eSpark-Backup/eyadkishawi-interfaceboard/README.md

# eyadkishawi-InterfaceBoard

- Transfer schematic to Altium.
- Modify schematics, layout and BOM to make the following modifications:
  - Remove R12 and leave open
  - Modify C10 to connect from R13 to GND.



  - c.	Replace C32 with 10uF Tantalum capacitor rated at 35V, such as TCJB106M035R0200.



- Rename the project to 7000-0303_Rev13.
- Schematic and more details are in the docs folder.
