eSpark-Backup/eyadkishawi-interfaceboard/docs/Requirements/7000-0303_r12_c10_mod_032323.pdf

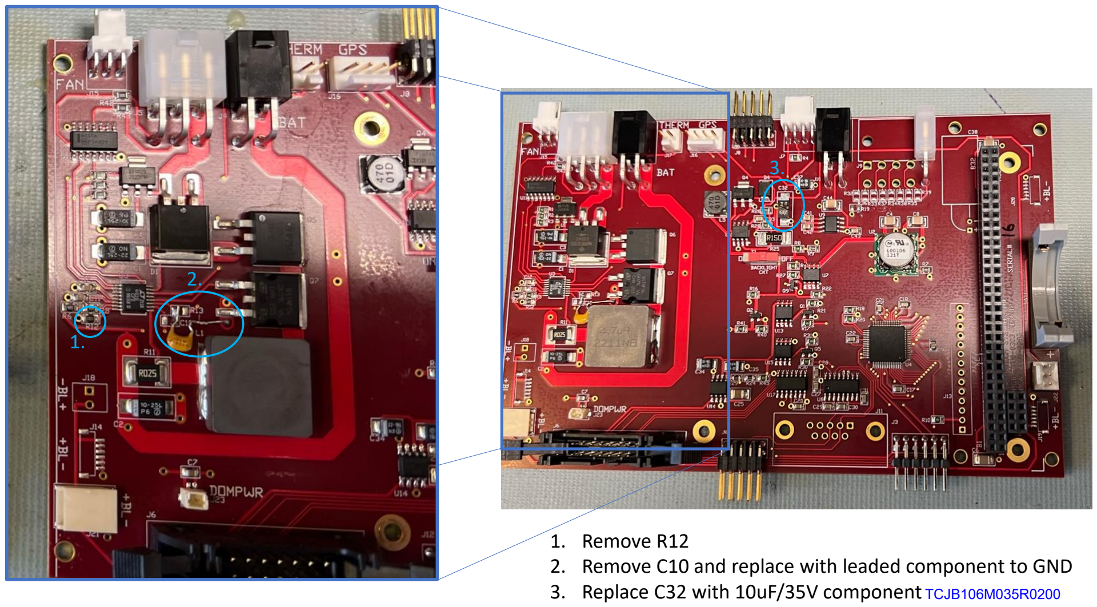
[picture p3: page 1]

1. Remove R12
2. Remove C10 and replace with leaded component to GND
3. Replace C32 with 10uF/35V component

1.

2.

3.

TCJB106M035R0200
