eSpark-Backup/eyadkishawi-interfaceboard/Design-Files/7000_0303_Rev13/Renderings/2D_Bottom_Layer.PNG

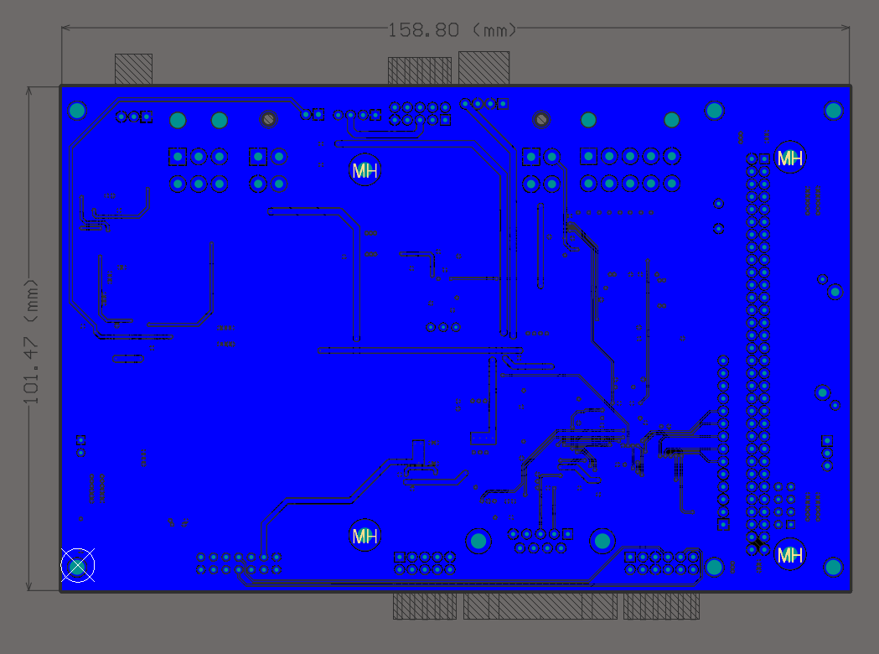
Design-Files/7000_0303_Rev13/Renderings/2D_Bottom_Layer.PNG
