eSpark-Backup/eyadkishawi-interfaceboard/Design-Files/7000_0303_Rev13/Renderings/3D_Bottom.PNG

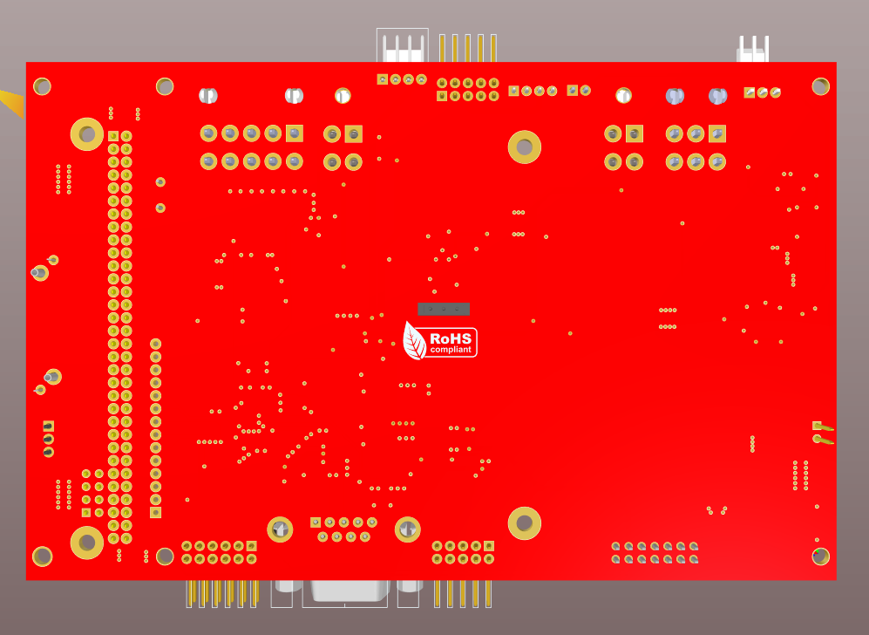
Design-Files/7000_0303_Rev13/Renderings/3D_Bottom.PNG
