eSpark-Backup/eyadkishawi-interfaceboard/docs/PCB/7000_0303_Rev12_Top.PNG

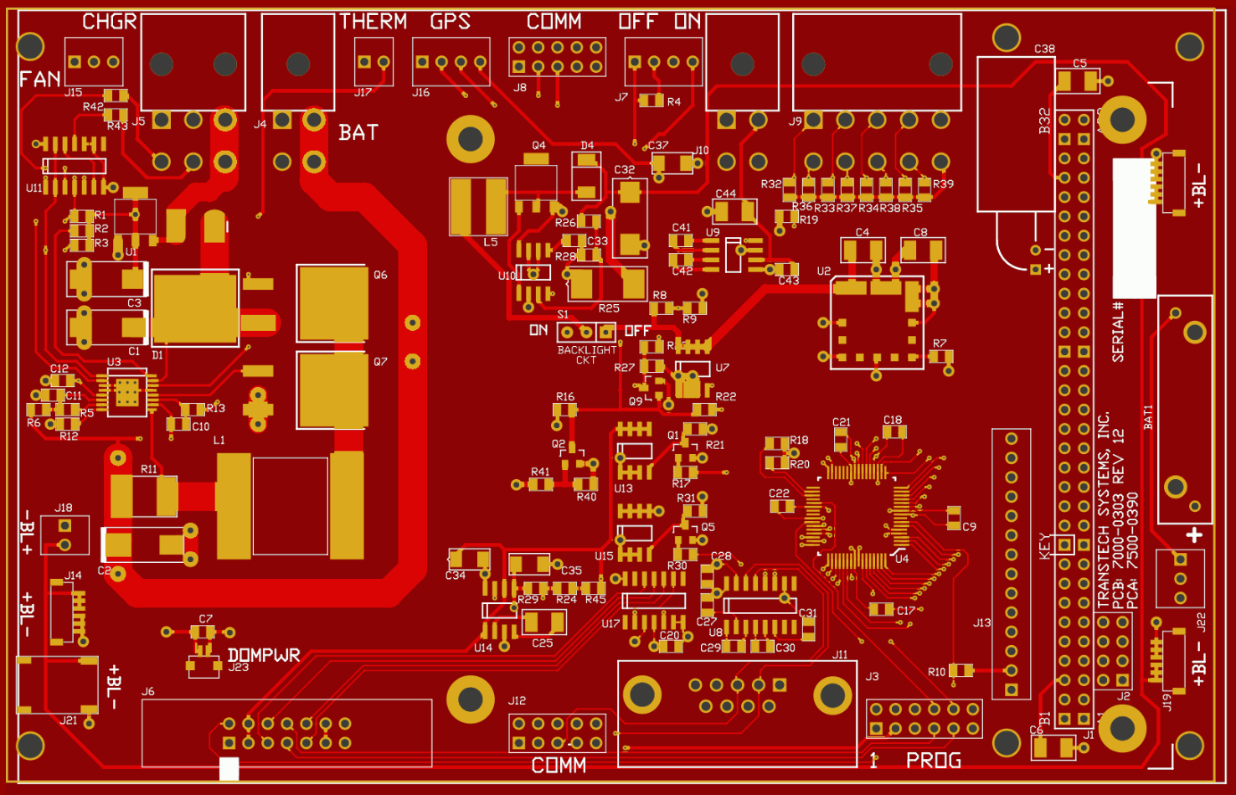
docs/PCB/7000_0303_Rev12_Top.PNG
