eSpark-Backup/eyadkishawi-interfaceboard/Design-Files/7000_0303_Rev13/BOM/BOM-7000_0303_Rev13.xlsx

# | Item Type | Designator | Description | Footprint | Manufacturer Part Number | Manufacturer | Value | Quantity | Remarks
1 | Tantalum Capacitors | C1 | CAP TANT 22UF 10% 25V 2312 | Case-C | TR3C226K025C0250 | Vishay Sprague | 22uF | 1
2 | Capacitor | C2, C3 | 10uF 25V 2.5Ω@100kHz ±10% CASE-B-3528 Tantalum Capacitors ROHS | Case-B | CA45-B025K106T | Xiangyee in S&T | 10uF | 2
3 | Capacitor | C4, C8, C25, C44 | CAP CER, 4.7 µF, 25 V, 0603 | Cap-0603 | C1608X5R1E475KT000E | TDK | 4.7uF | 4
4 | Capacitor | C5, C6, C7 | CAP CER 100UF 16V X5R 1210 | Cap-1210 | EMK325ABJ107MM-P | Taiyo Yuden | 100uF | 3
5 | Capacitor | C9, C10, C17, C18, C20, C21, C22, C27, C28, C29, C30, C31, C33, C43, C45 | CAP CER 0.1UF 100V X7R 0603 | Cap-0603 | CC0603KRX7R0BB104 | Yageo | 0.1uF | 15
6 |  | C11 | CAP CER 0.033UF 50V X7R 0603 | Cap-0603 | CL10B333KB8NNNC | Samsung | 33nF | 1
7 | Capacitors | C12 | CAP CER 0.068UF 50V X7R 0603 | Cap-0603 | CC0603KRX7R9BB683 | Yageo | 68nF | 1
8 | Tantalum Capacitors | C32 | CAP TANT 10UF 10% 35V 2312 | Case-C | TAJC106K035RNJ | Kyocera AVX | 10uF | 1
9 | Tantalum Capacitor | C34, C35, C37 | CAP TANT 22UF 10% 16V 1411 | Case-B | TAJB226K016RNJ | Kyocera AVX | 22uF | 3
10 | Capacitors | C38 | 3300uF 6.3V ±20% Plugin,D10xL23mm Aluminum Electrolytic Capacitors - Leaded ROHS | 6ME3300WG | 6ME3300WG | SUNCON(SUN Elec Industries) | 3300uF | 1
11 | Capacitor | C41, C42 | CAP CER 0.22UF 10V X7R 0603 | Cap-0603 | CC0603KRX7R6BB224 | Yageo | 220nF | 2
12 | Rectifier Diodes | D1 | DIODE ARR SCHOTT 60V 20A TO263AB | VS-48CTQ060S-M3 | VS-48CTQ060S-M3 | Vishay Semiconductors | - | 1
13 | Diode | D4 | 40V 3A 570mV SMB Schottky Barrier Diodes (SBD) ROHS | SMB_ | STPS340U | Tokmas | - | 1
14 | Connectors | J1 | CONN SOCKET 64POS 0.1 GOLD PCB | ESW-132-12-G-D | ESW-132-12-G-D | Samtec | - | 1
15 | Female Header | J2 | Battery Holder Vertical | HDR 2x4 Female Header | ESW-104-12-G-D | Samtec | - | 1
16 | Pin Header | J3 | 250V 3A Right-Angle Square Pins 2.54mm 12P 6mm -40℃~+105℃ 2.54mm 双排 Black 2x6P 2.54mm Push-Pull,P=2.54mm Pin Headers ROHS | HDR 2x6TH (rigth angle) | CS-1107-2X6(L14/19) | CST | - | 1
17 | Headers and Wire Housings | J4, J10 | CONN HEADER R/A 4POS 4.2MM | 39300040 | 39-30-0040 | Molex | - | 2
18 | Headers, Male Pins | J5 | CONN HEADER R/A 6POS 4.2MM | 39301060 | 39301060 | Molex | - | 1
19 | IDC Connectors | J6 | 2.54mm Straight 2x7P 7 Horn buckle 2.54mm 2 Plugin,P=2.54mm IDC Connectors ROHS | 2.54-2*7P | 2.54-2*7P | BOOMELE | - | 1
20 | Wire To Board Connector | J7 | CONN HEADER R/A 4POS 2.54MM | 22053041 | 22053041 | Molex | - | 1
21 | Pin Header | J8, J12 | Right-Angle 2.5mm 6mm 10P 2.54mm 双排 2x5P Plugin,P=2.54mm Pin Headers ROHS | HDR 2x5TH (rigth angle) | 2541WR-2x05P | HanElectricity | - | 2
22 | Wire To Board Connector | J9 | CONN HEADER R/A 10POS 4.2MM | 39301100 | 39301100 | Molex | - | 1
23 | VGA connector | J11 | 9P Female D-Sub Right-Angle 2 3A -50℃~+105℃ Push-Pull D-Sub / VGA connector ROHS | D-DMR009PF-D002 | D-DMR009PF-D002 | Ckmtw | - | 1
24 | Through Hole Pads | J13 | Wire Connecting Pads | 14P Through Hole Pads_ | 14P Through Hole Pads |  | DNP | 1
25 | Headers and Wire Housings | J14, J19, J20 | CONN HEADER SMD R/A 6POS 1MM | SM06B-SHLS-TF(LF)(SN) | SM06B-SHLS-TF(LF)(SN) | JST | - | 3
26 | Headers, Male Pins | J15 | CONN HEADER R/A 3POS 2.54MM | 22053031 | 22053031 | Molex | - | 1
27 | Wire To Board Connector | J16 | 1x4P 1 2.54mm Male pin 4 -25℃~+85℃ 3A Straight Plugin,P=2.54mm Wire To Board / Wire To Wire Connector ROHS | M2510V-04P | M2510V-04P | XFCN | - | 1
28 | Headers, Male Pins | J17 | CONN HEADER VERT 2POS 2.54MM | 22112022 | 22112022 | Molex | - | 1
29 | Header | J18 | 2.54mm Plugin 3A 2P Straight 1x2P 8.5mm Top Square Holes Plugin,P=2.54mm Female Headers ROHS | HDR1X2 (Female) | DM254R-11-02-85 | DEALON | - | 1
30 | Headers and Wire Housings | J21 | CONN HEADER SMD R/A 2POS 3.5MM | SM02B-BHSS-1-TB(LF)(SN) | SM02B-BHSS-1-TB(LF)(SN) | JST | - | 1
31 | Headers, Male Pins | J22 | CONN HEADER VERT 3POS 2.54MM | 22112032 | 22112032 | Molex | - | 1
32 | Connectors | J23 | CONN HEADER SMD 2POS 1MM | BM02B-SRSS-TB(LF)(SN) | BM02B-SRSS-TB(LF)(SN) | JST | - | 1
33 | Batteries and Accessories | J24 | Coin Cell Battery Holders VERT HOLDER FOR OR CR2477N | NH5077-LF | NH5077-LF | Renata | - | 1
34 | Inductors | L1 | 28A 4.7uH ±20% 61.2A 2.6mΩ SMD-3P,19.7x27.9mm Inductors (SMD) ROHS | THC2818-4R7M | THC2818-4R7M | KOHERelec | 4.7uH | 1
35 | Inductors | L5 | 3A 47uH Molding Choke ±20% 4.5A SMD Power Inductors ROHS | SMMS1050-470M | SMMS1050-470M | SXN | 47uH | 1
36 | Mosfet | Q1, Q2, Q5, Q9 | TRANS NPN 40V 0.6A SMD SOT23-3 | SOT-23 | MMBT2222A-7-F | Diodes | - | 4
37 | MOSFET | Q4 | 60V 4A 1PCSNChannel SOT-223 MOSFETs ROHS | SOT- 223 | NTF3055L175T1G-VB | VBsemi Elec | - | 1
38 | MOSFETs | Q6 | MOSFET P-CH 60V 27A D2PAK | D2Pak. | FQB27P06TM | ON Semiconductor / Fairchild | - | 1
39 | MOSFETs | Q7 | MOSFET N-CH 60V 50A D2PAK | STB55NF06T4 | STB55NF06T4 | STMicroelectronics | - | 1
40 | Resistor | R1, R2, R3, R5, R8, R10, R13, R16, R21, R27, R28, R31, R32, R33, R34, R35, R36, R37, R38, R39, R40, R41, R45 | RES SMD 10K OHM 0.1% 1/10W 0603 | Res-0603 | RT0603BRD0710KL | Yageo | 10K | 23
41 | Resistor | R4, R17, R18, R20, R22, R23, R30 | RES SMD 1K OHM 1% 1/10W 0603 | Res-0603 | RC0603FR-071KL | Yageo | 1K | 7
42 | Resistor | R6 | RES 49.9K OHM 1% 1/10W 0603 | Res-0603 | RC0603FR-0749K9L | Yageo | 49K9 | 1
43 | Resistor | R7 | 100mW Thick Film Resistors 75V ±100ppm/℃ ±1% 1.3kΩ 0603 Chip Resistor - Surface Mount ROHS | Res-0603 | 0603WAF1301T5E | UNI-ROYAL | 1.3K | 1
44 | Resistor | R9 | 100mW Thick Film Resistors ±100ppm/℃ ±1% 1MΩ 0603 Chip Resistor - Surface Mount ROHS | Res-0603 |  | UNI-ROYAL(Uniroyal Elec) | 4.99K | 1
45 | Resistor | R11 | RES 0.025 OHM 1% 1W 2512 | RES-2512 | WSL2512R0250FEA | Vishay Dale | 0.025R | 1
46 | Resistor | R19 | 100mW Thick Film Resistors ±100ppm/℃ ±1% 1MΩ 0603 Chip Resistor - Surface Mount ROHS | Res-0603 |  | UNI-ROYAL(Uniroyal Elec) | 1M | 1
47 | Resistor | R24, R29 | RES 100K OHM 5% 1/10W 0603 | Res-0603 | RC0603JR-07100KL | Yageo | 100K | 2
48 | Resistor | R25 | 1W 40mΩ Surface Mount Current Sensing Resistors ±50ppm/℃ ±1% 1206 Current Sense Resistors/Shunt Resistors ROHS | Res-1206 | LR1206-21R040F4 | RALEC | 40mR | 1
49 |  | R26 | RES 56K OHM 1% 1/10W 0603 | Res-0603 | RC0603FR-0756KL | Yageo | 56K | 1
50 | Resistor | R42, R43 | RES SMD 100 OHM 1% 1/10W 0603 | Res-0603 | RC0603FR-07100RL | Yageo | 100R | 2
51 | Slide Switches | S1 | SWITCH SLIDE SPDT 500MA 12V | SM0320102 | SM0320102 | NKK Switches | - | 1
52 | LDO | U1 | 75dB@(120Hz) 1A Fixed 5V Positive electrode 12V SOT-223-3 Linear Voltage Regulators (LDO) ROHS | SOT- 223 | LM1117S-5.0 | HTC Korea TAEJIN Tech | - | 1
53 | Board Mount Modules | U2 | DC DC CONVERTER 0.591-5.5V 30W | OKL-T/6-W12P-C | OKL-T/6-W12P-C | Murata | - | 1
54 | IC | U3 | IC BATT CHG MULTI 1-16C 16TSSOP | TSSOP-16-EP | LTC4010CFE#PBF | Analog Devices / Linear Technology | - | 1
55 | IC | U4 | IC MCU 8BIT 96KB FLASH 64TQFP | 64-TQFP (10x10) | PIC18F6627-I/PT | Microchip | - | 1
56 | Mosfet | U7, U13, U15 | SOIC-8 MOSFETs ROHS | SOIC-8 | FDS4435A | TECH PUBLIC | - | 3
57 | IC | U8 | 140Kbps transceiver SOP-16 RS232 ICs ROHS | SOP-16 | MAX232EIM/TR | HGSEMI | - | 1
58 | IC | U9 | IC REG CHRG PUMP 12V 30MA 8SOIC | SOIC-8(0.154", 3.90mm Width) | MAX662AESA+T | Maxim | - | 1
59 | IC | U10 | Switching Controllers 12V or Adjustable, High-Efficiency, Low IQ, Step-Up DC-DC Controller | SOIC-8(0.150", 3.80mm Width) | MAX1771ESA+ | Maxim | - | 1
60 | IC | U11 | IC GATE NAND 4CH 2-INP 14SOIC | SOIC-14 | MM74HC00M | ON Semiconductor / Fairchild | - | 1
61 | IC | U14 | IC REG CHRG PUMP ADJ 200MA 8SOIC | SOIC-8(0.154", 3.90mm Width) | MAX889RESA+ | Maxim | - | 1
62 | IC | U17 | IC TRANSCEIVER FULL 1/1 14SOIC | SOIC-14 | MAX3080ECSD+ | Maxim | - | 1
