eSpark-Backup/eyadkishawi-interfaceboard/(list of files, cad)

Other CAD files:
Design-Files/7000_0303_Rev13/Supporting Files/PCB_7000_0303_Rev13.DXF
Design-Files/7000_0303_Rev13/Supporting Files/PCB_7000_0303_Rev13.DWG
