eSpark-Backup/eyadkishawi-interfaceboard/docs/Schematic/7000_0303_Rev12.pdf

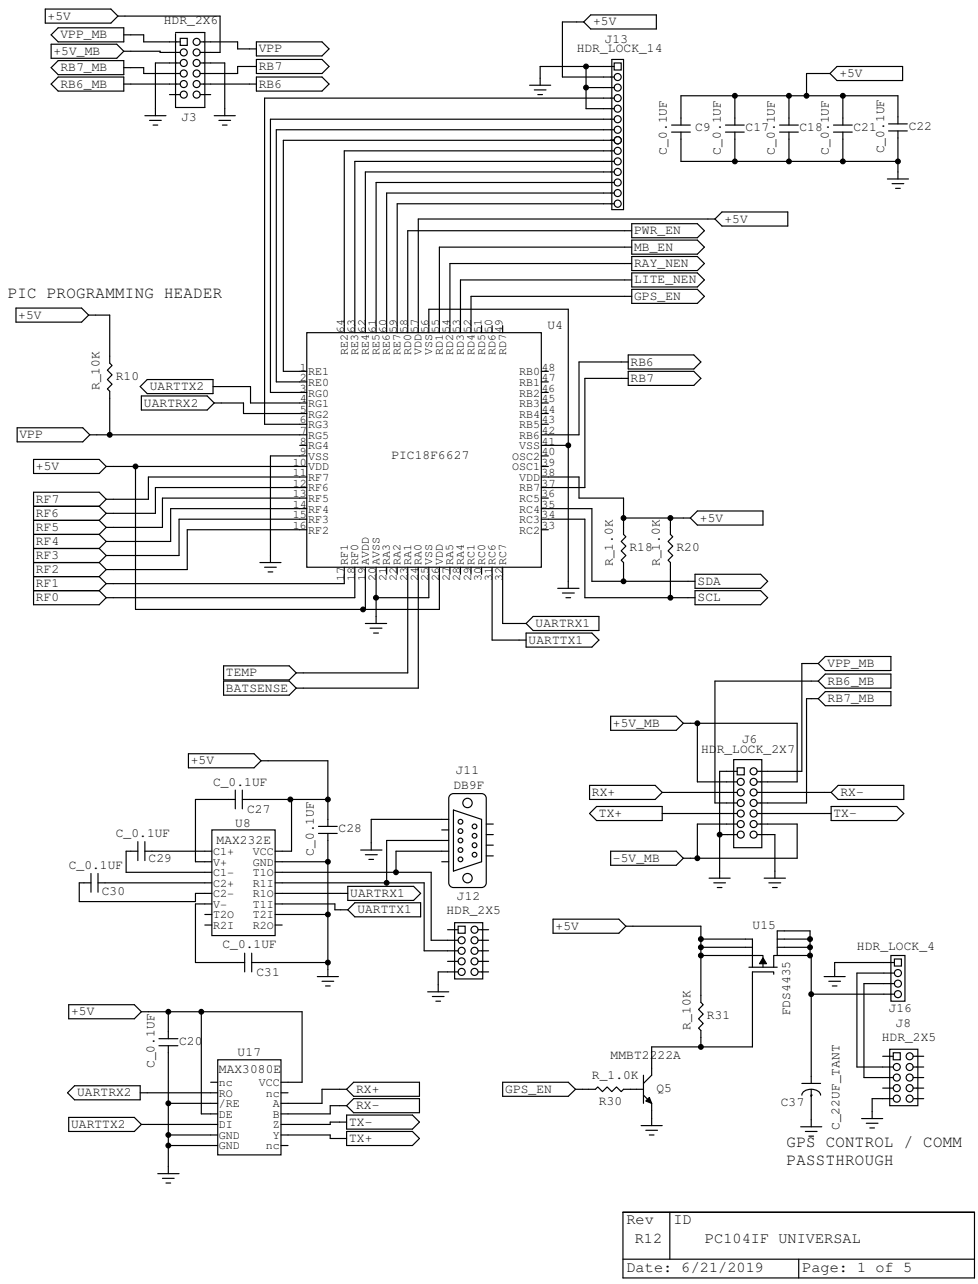
[picture p12: page 1]

17 RF1 18 RF0 19 AVDD 20 AVSS 21 RA3 22 RA2 23 RA1 24 RA0 25 VSS 26 VDD 27 RA5 28 RA4 29 RC1 30 RC0 31 RC6 32 RC7

Rev R12 | ID PC104IF UNIVERSAL

Date: 6/21/2019 | Page: 1 of 5

# Replace with TCJB106M035R0200

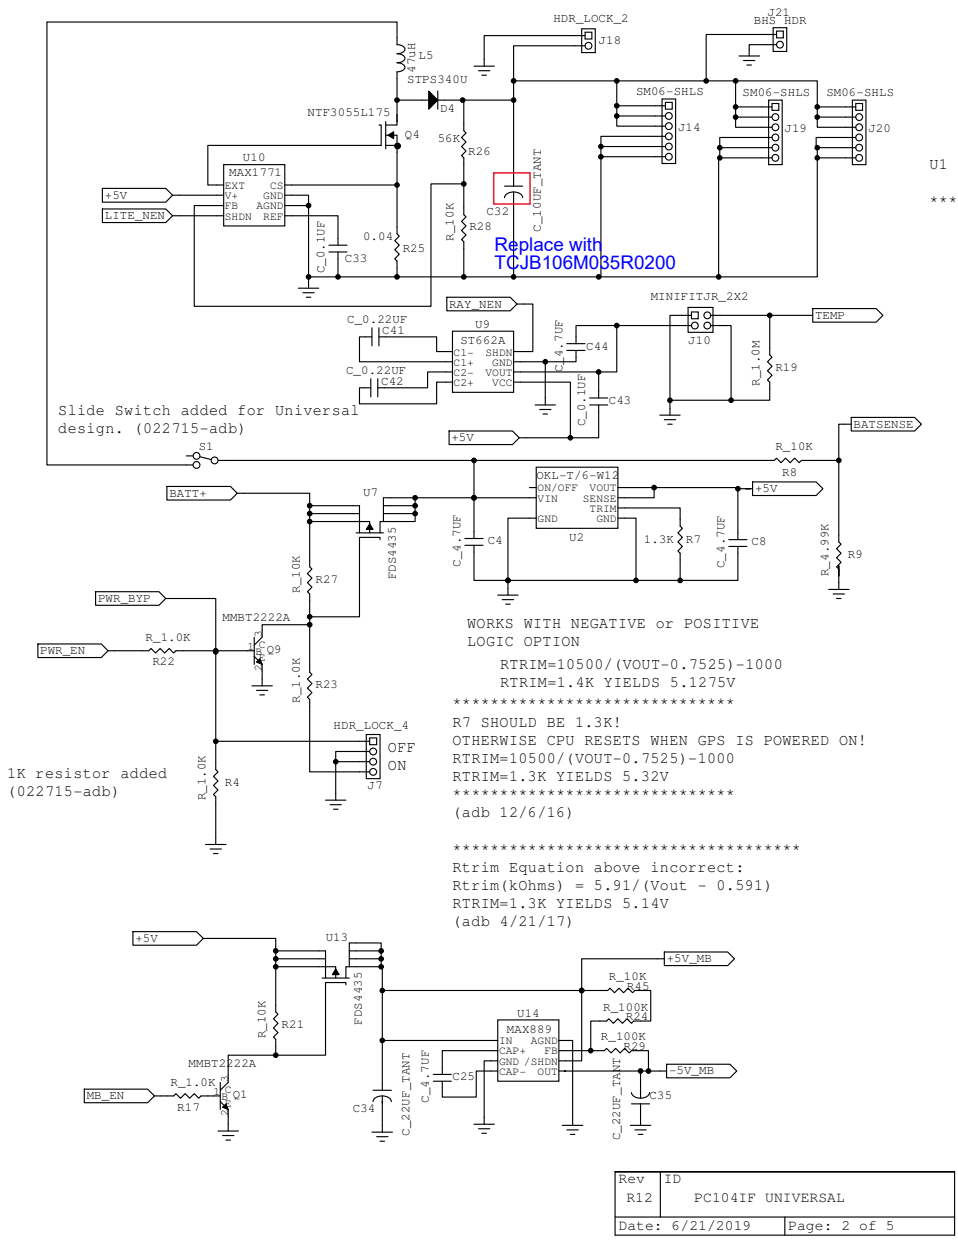
[picture p13: page 2]

Slide Switch added for Universal
design. (022715-adb)

WORKS WITH NEGATIVE or POSITIVE
LOGIC OPTION
RTRIM=10500/(VOUT-0.7525)-1000
RTRIM=1.4K YIELDS 5.1275V

R7 SHOULD BE 1.3K!
OTHERWISE CPU RESETS WHEN GPS IS POWERED ON!
RTRIM=1.3K YIELDS 5.32V
(adb 12/6/16)

Rtrim Equation above incorrect:
Rtrim(kOhms) = 5.91/(Vout - 0.591)
RTRIM=1.3K YIELDS 5.14V
(adb 4/21/17)

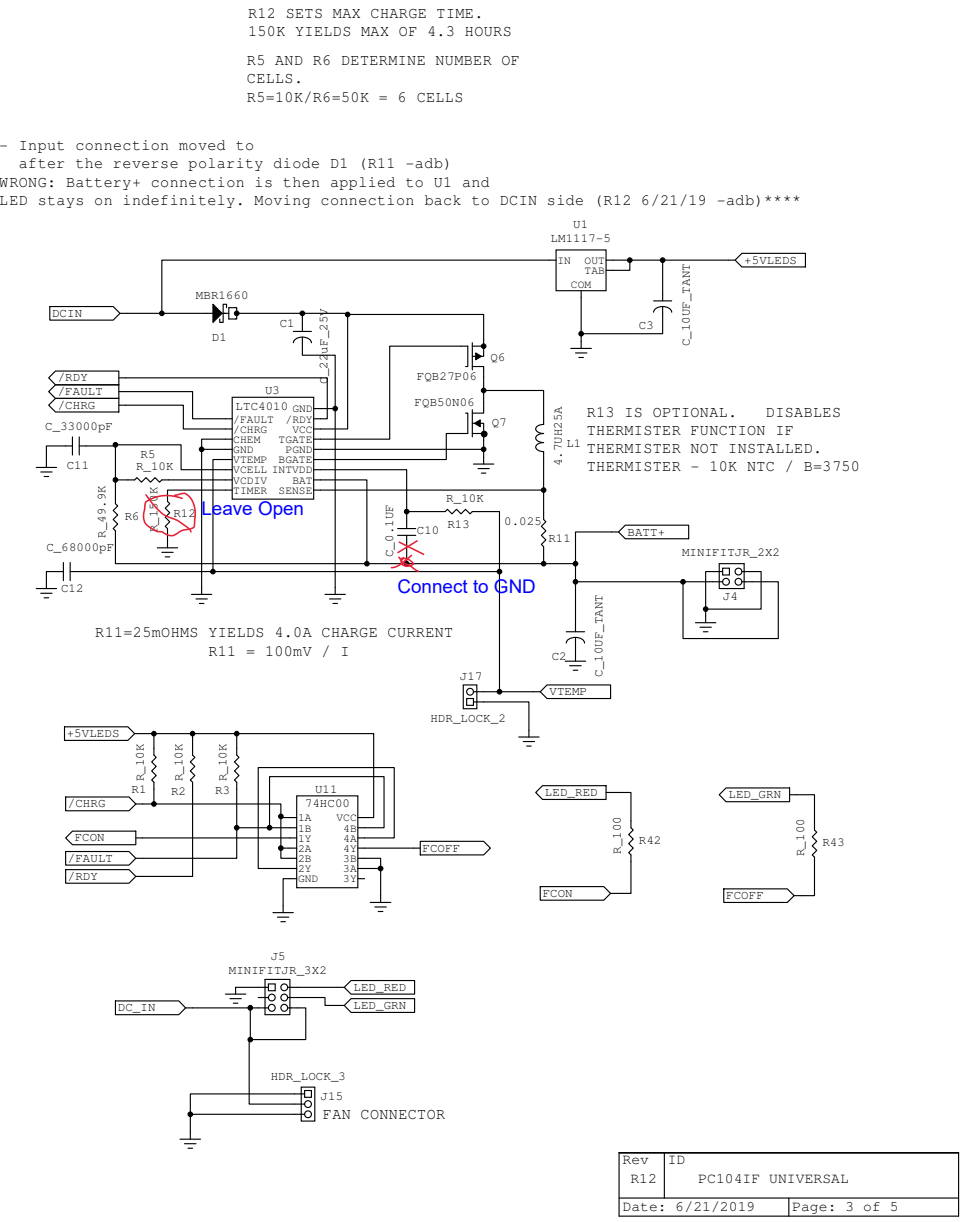
[picture p14: page 3]

R12 SETS MAX CHARGE TIME.
150K YIELDS MAX OF 4.3 HOURS

R5 AND R6 DETERMINE NUMBER OF
CELLS.
R5=10K/R6=50K = 6 CELLS

U1 - Input connection moved to

after the reverse polarity diode D1 (R11 -adb)

***WRONG: Battery+ connection is then applied to U1 and
LED stays on indefinitely. Moving connection back to DCIN side (R12 6/21/19 -adb)****

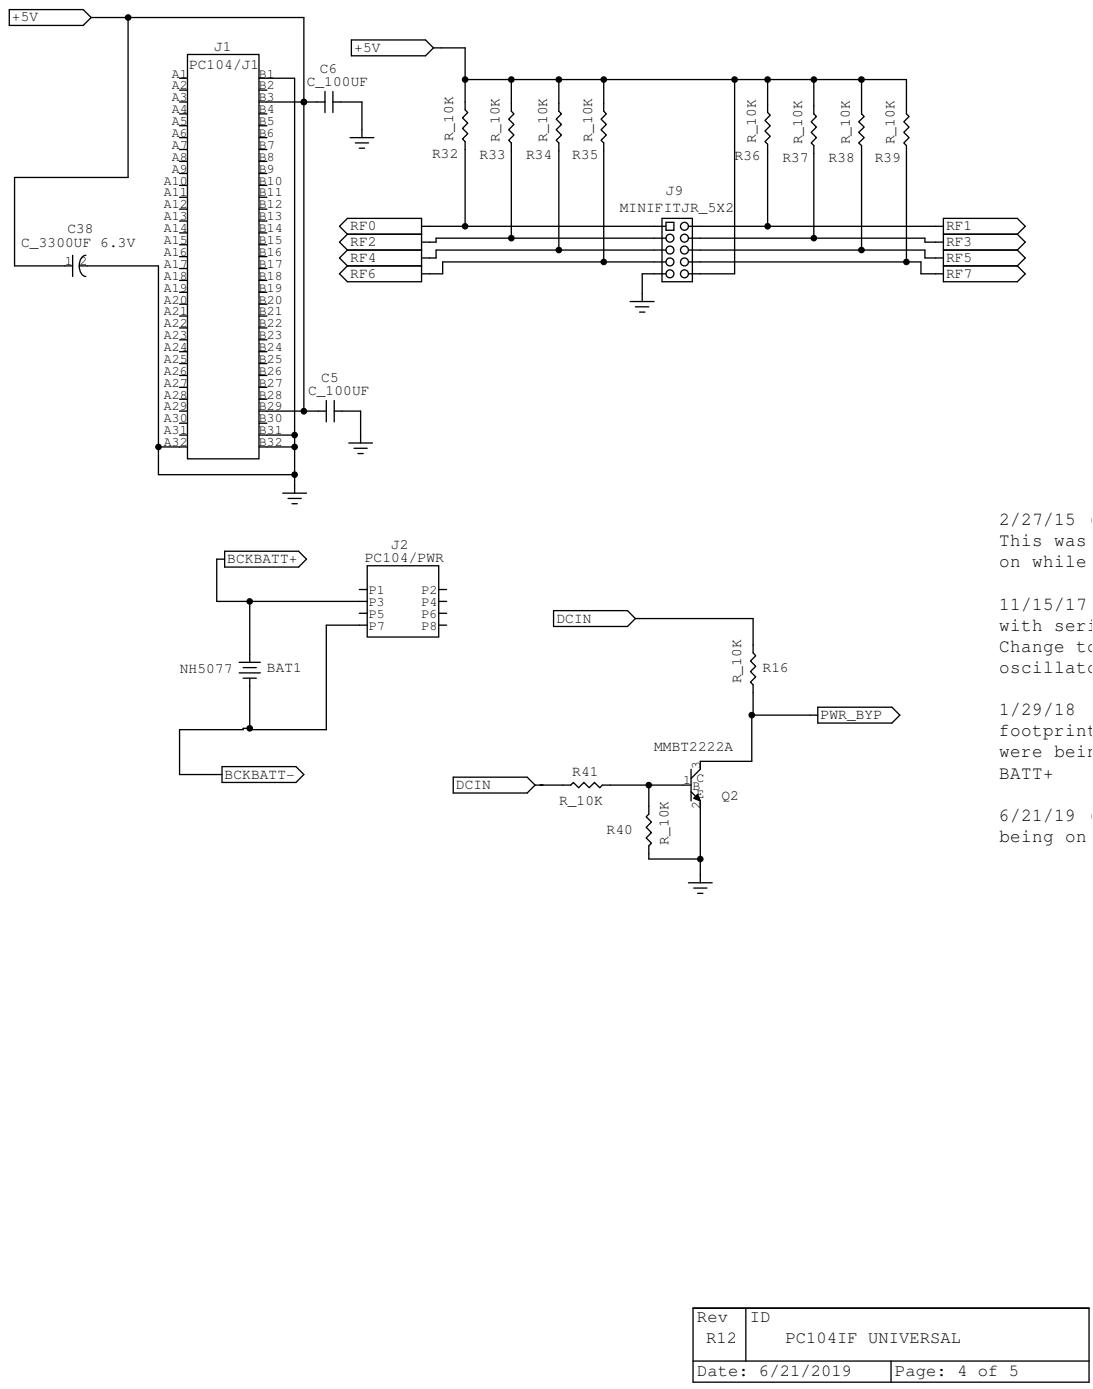
[picture p15: page 4]

with serial cable beneath SBC.
Change to
oscillator

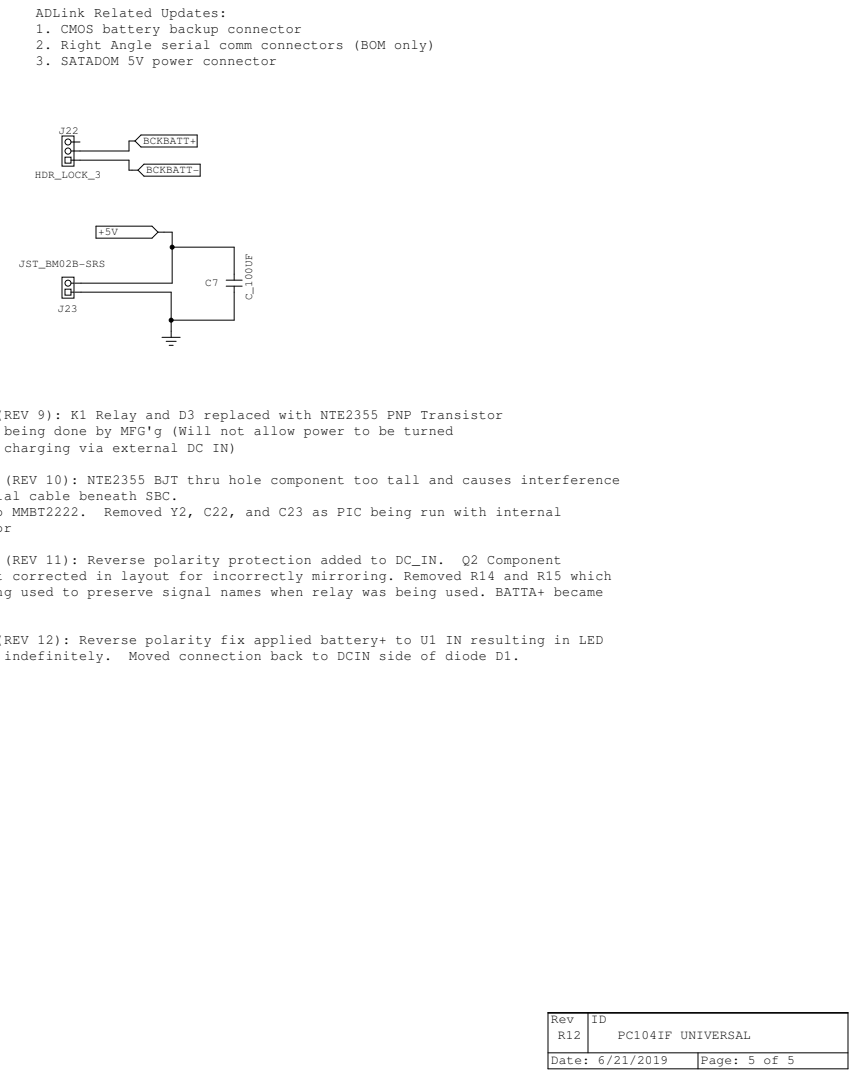
[picture p16: page 5]

ADLink Related Updates:
1. CMOS battery backup connector
2. Right Angle serial comm connectors (BOM only)
3. SATADOM 5V power connector

2/27/15 (REV 9): K1 Relay and D3 replaced with NTE2355 PNP Transistor
This was being done by MFG'g (Will not allow power to be turned
on while charging via external DC IN)

11/15/17 (REV 10): NTE2355 BJT thru hole component too tall and causes interference
with serial cable beneath SBC.

footprint corrected in layout for incorrectly mirroring. Removed R14 and R15 which
were being used to preserve signal names when relay was being used. BATTA+ became

6/21/19 (REV 12): Reverse polarity fix applied battery+ to U1 IN resulting in LED
