eSpark-Backup/eyadkishawi-interfaceboard/Design-Files/7000_0303_Rev13/Schematics/Assembly_Drawings.pdf

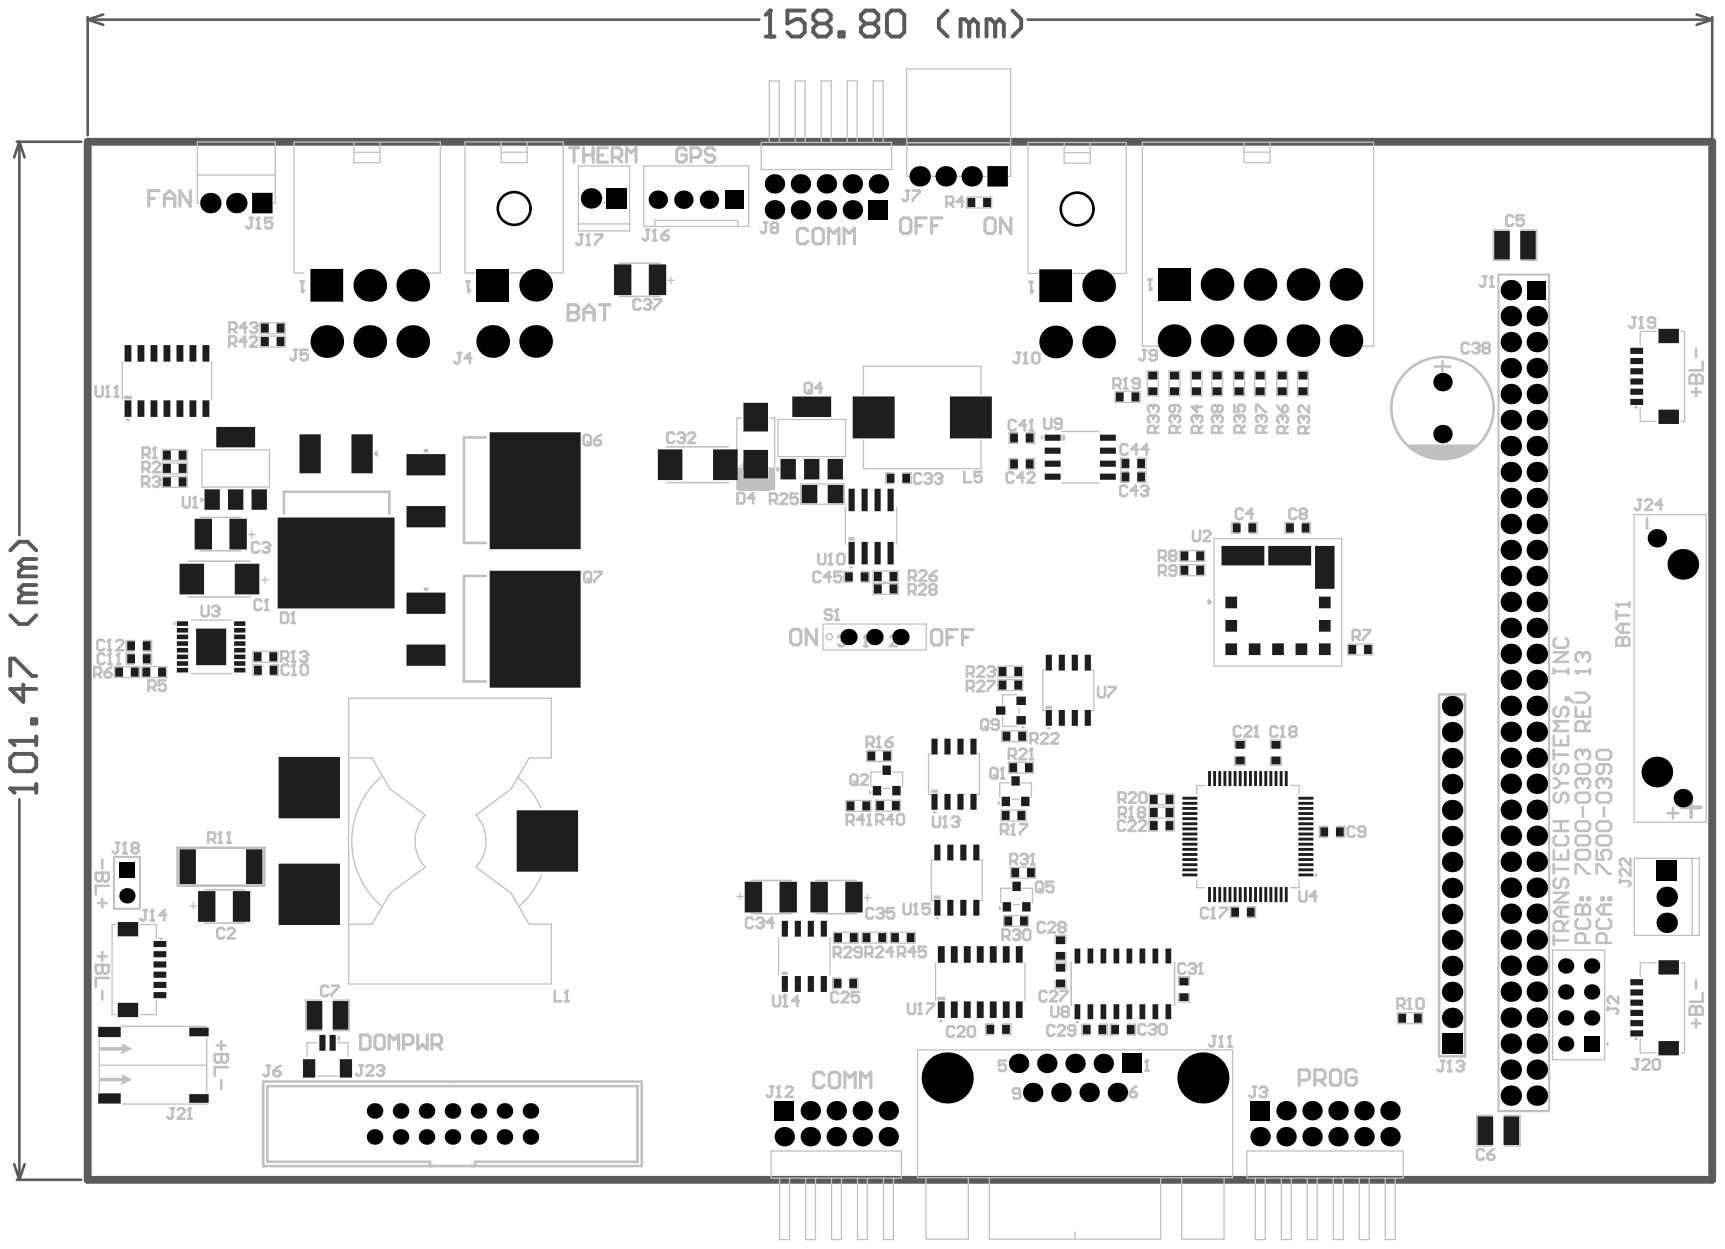
[picture p17: page 1]

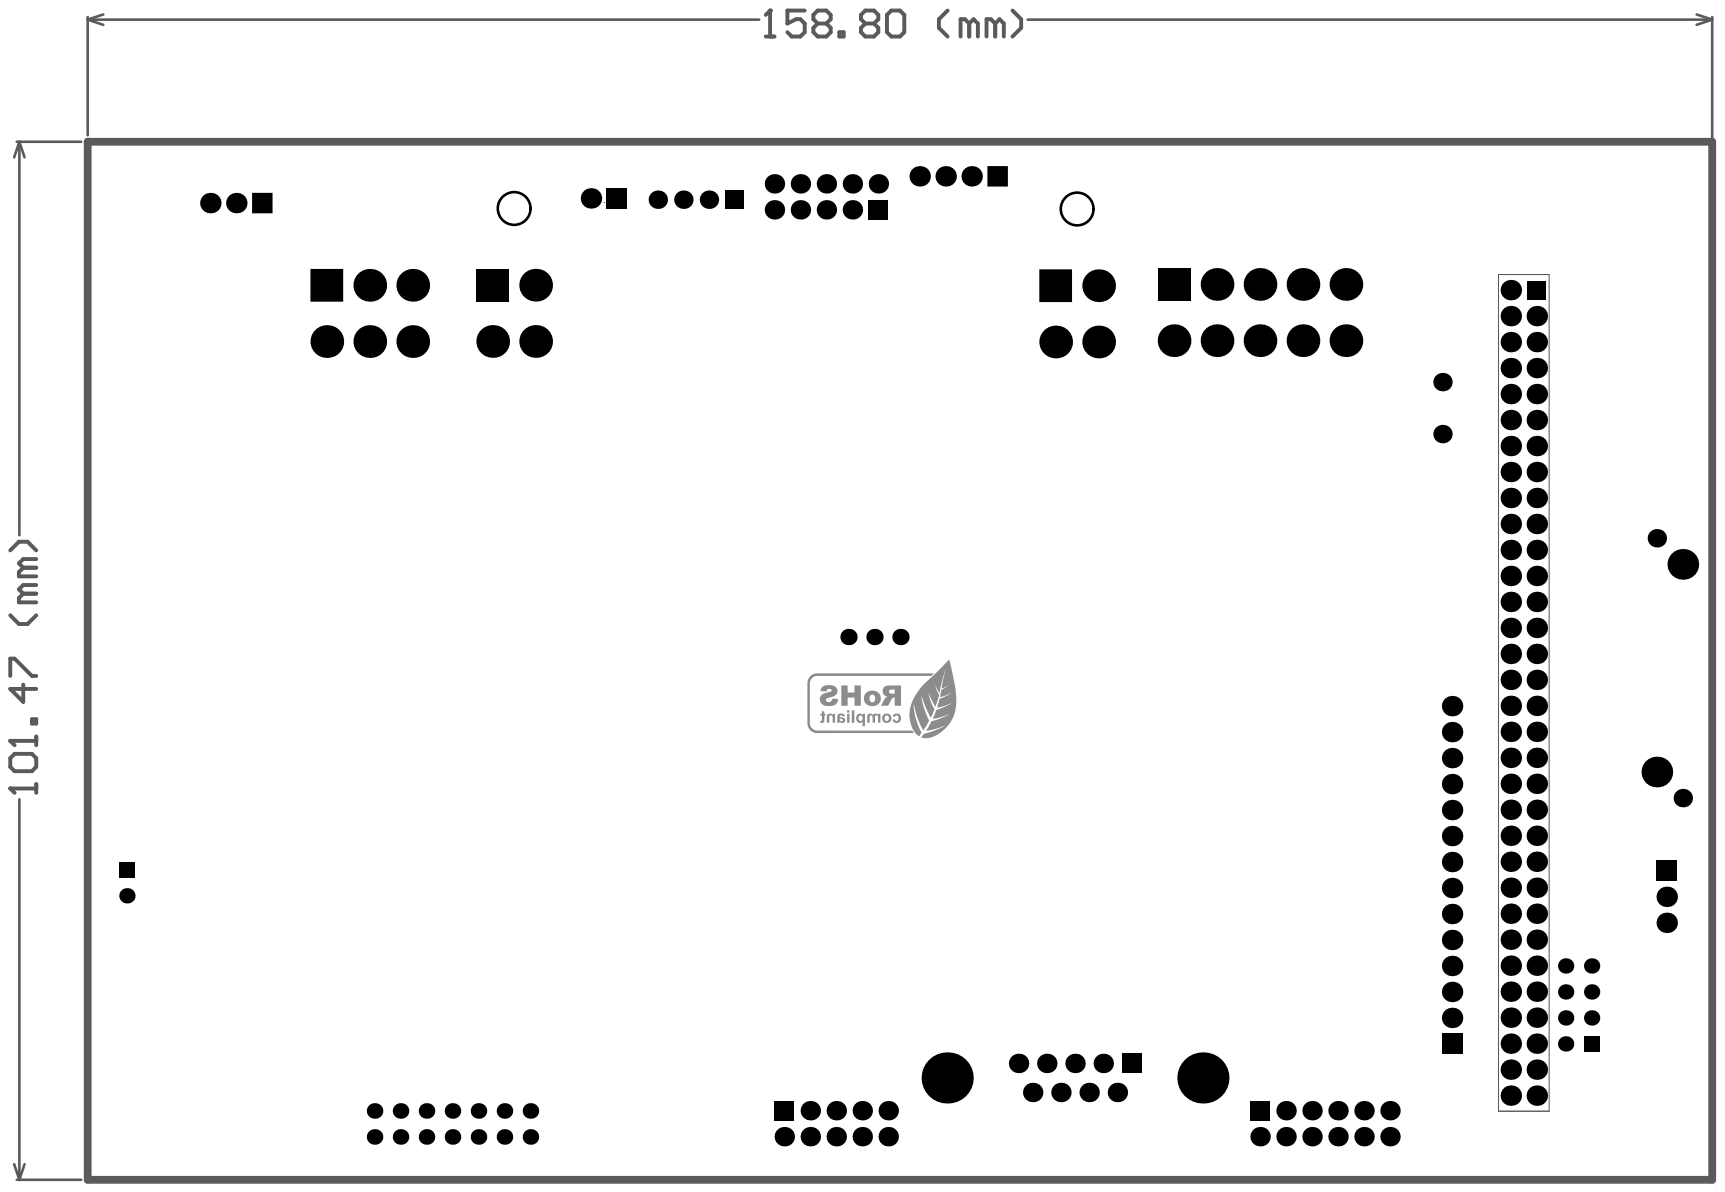
[picture p18: page 2]
