eSpark-Backup/eyadkishawi-interfaceboard/Design-Files/7000_0303_Rev13/Schematics/Schematic_7000_0303_Rev13.pdf

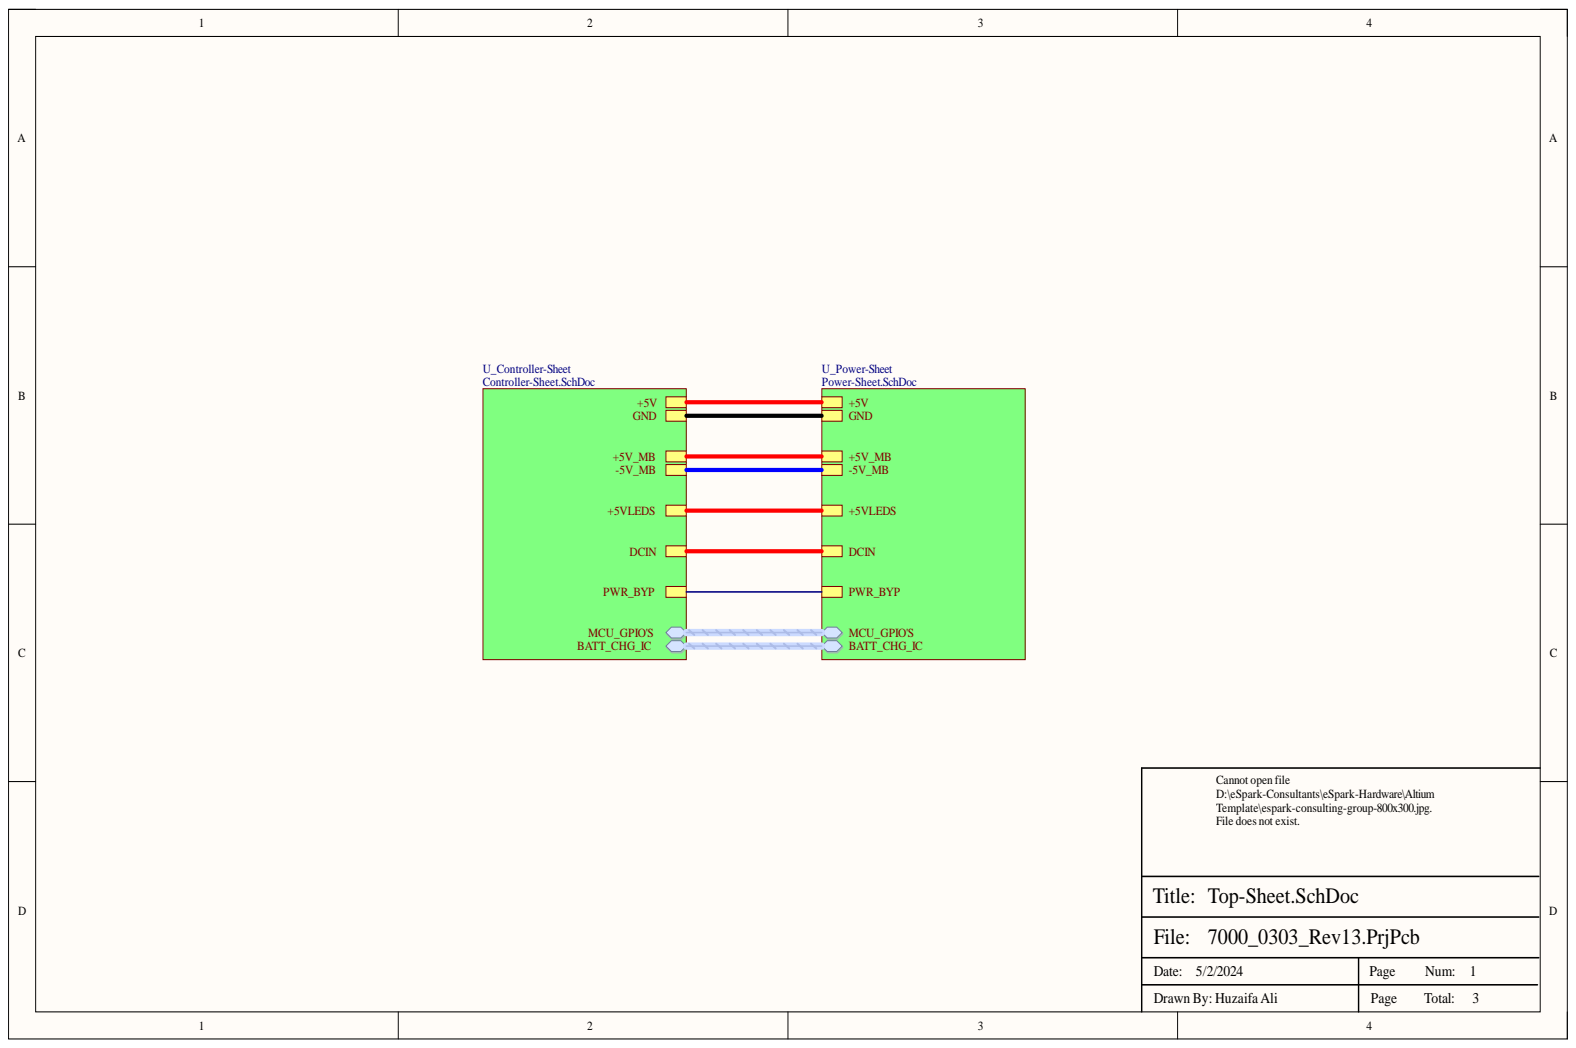
[picture p19: page 1]

Cannot open file
D:\eSpark-Consultants\eSpark-Hardware\Altium
Template\espark-consulting-group-800x300.jpg.
File does not exist.

Date: 5/2/2024 | Page Num: 1

Drawn By: Huzaifa Ali | Page Total: 3

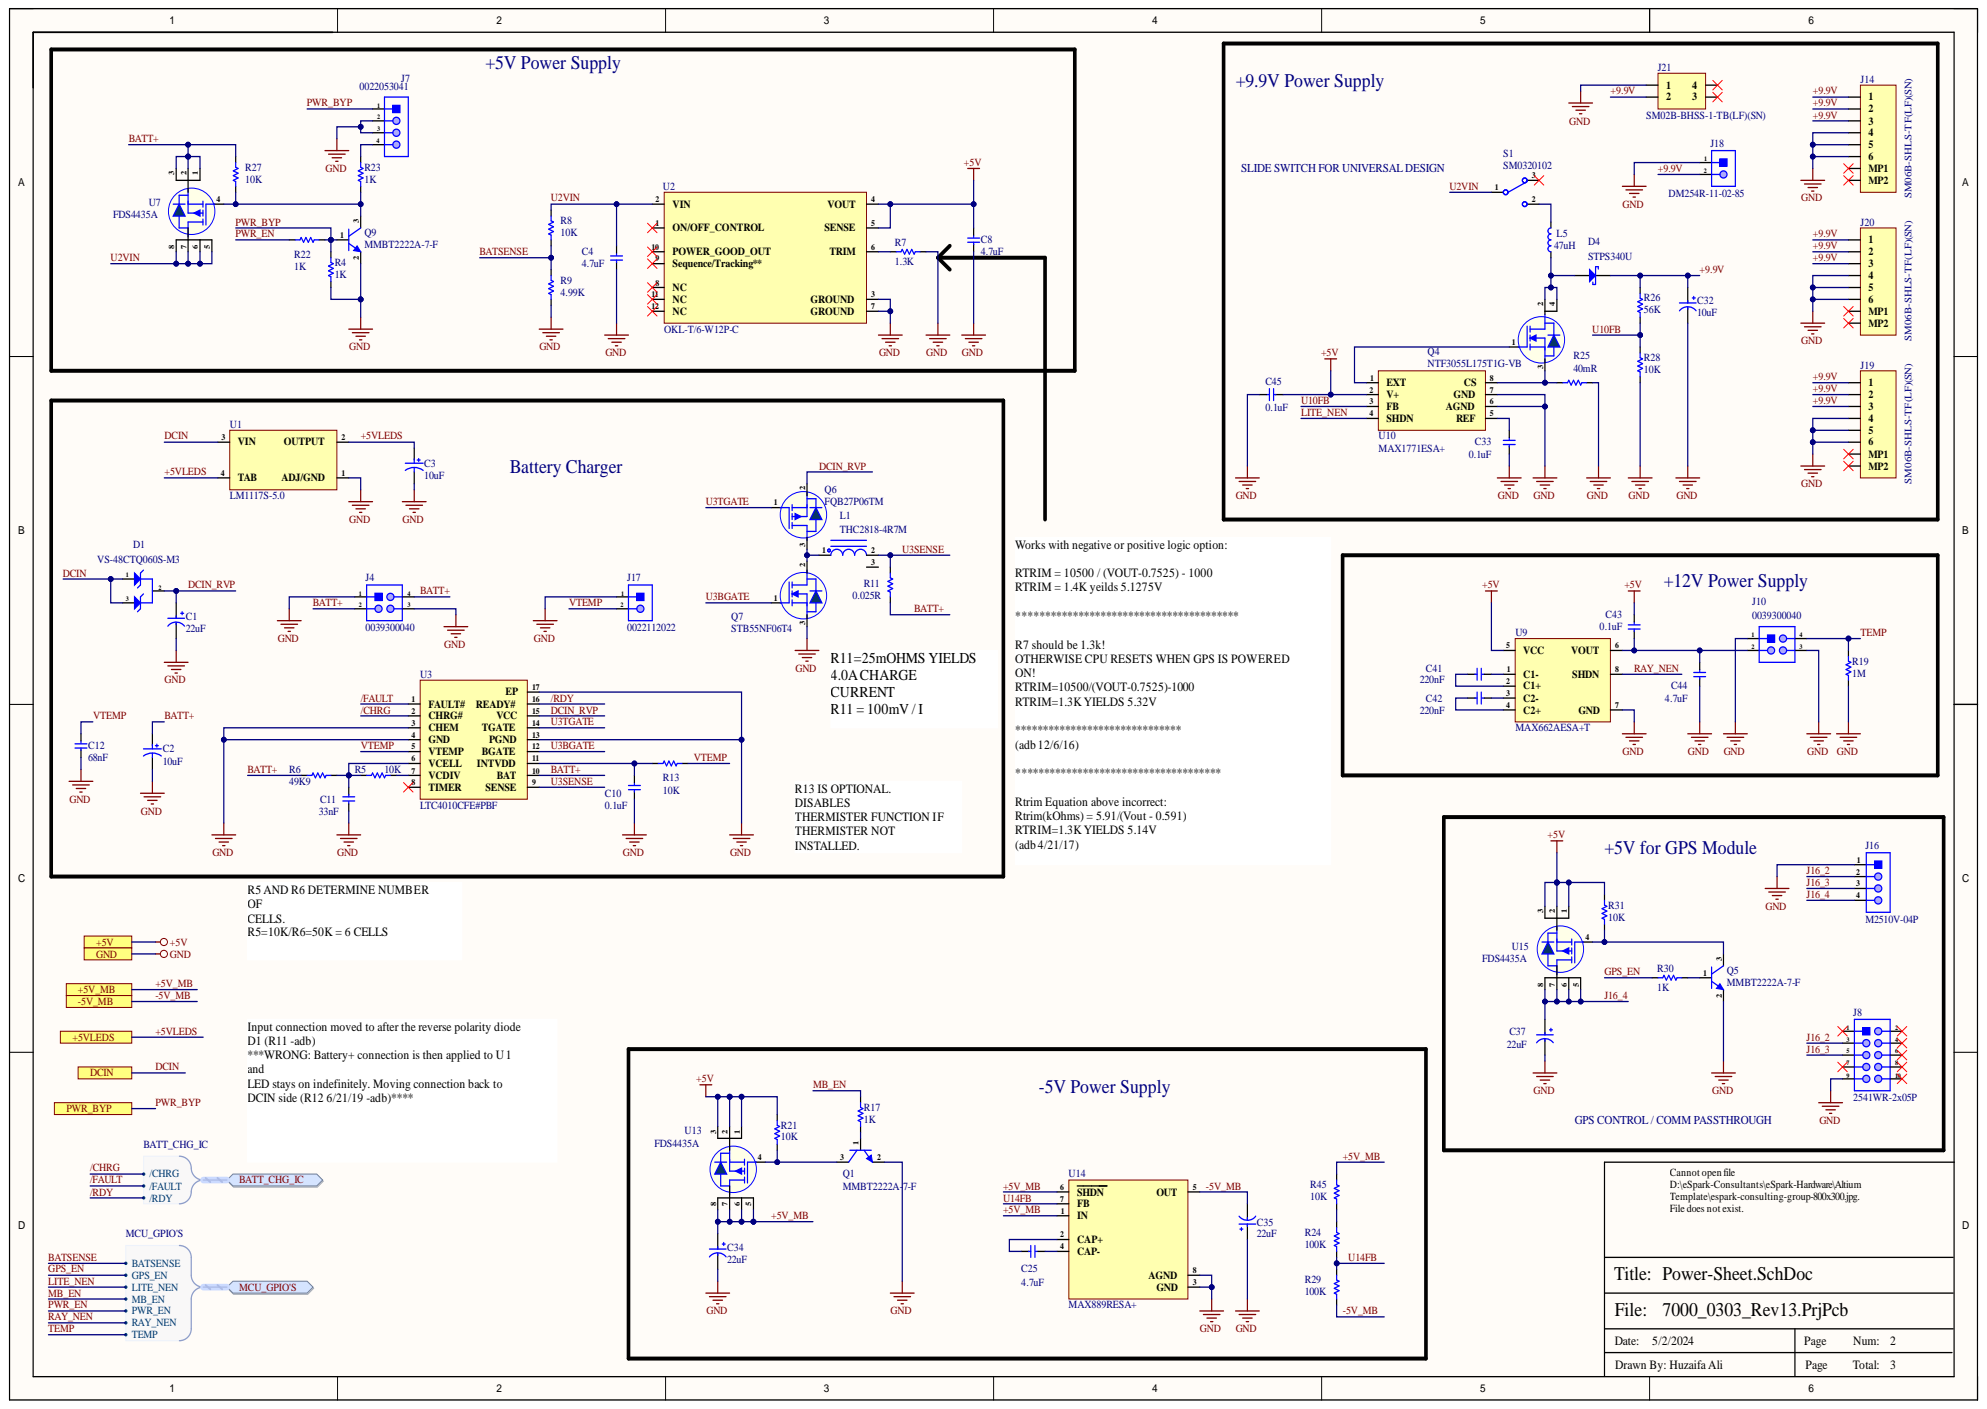
[picture p20: page 2]

SM06B-SHLS-TF(LF)(SN)

OTHERWISE CPU RESETS WHEN GP
ON! RTRIM=1

Can
D:\eSpark-Consultan
Template\espark-consulting-grou

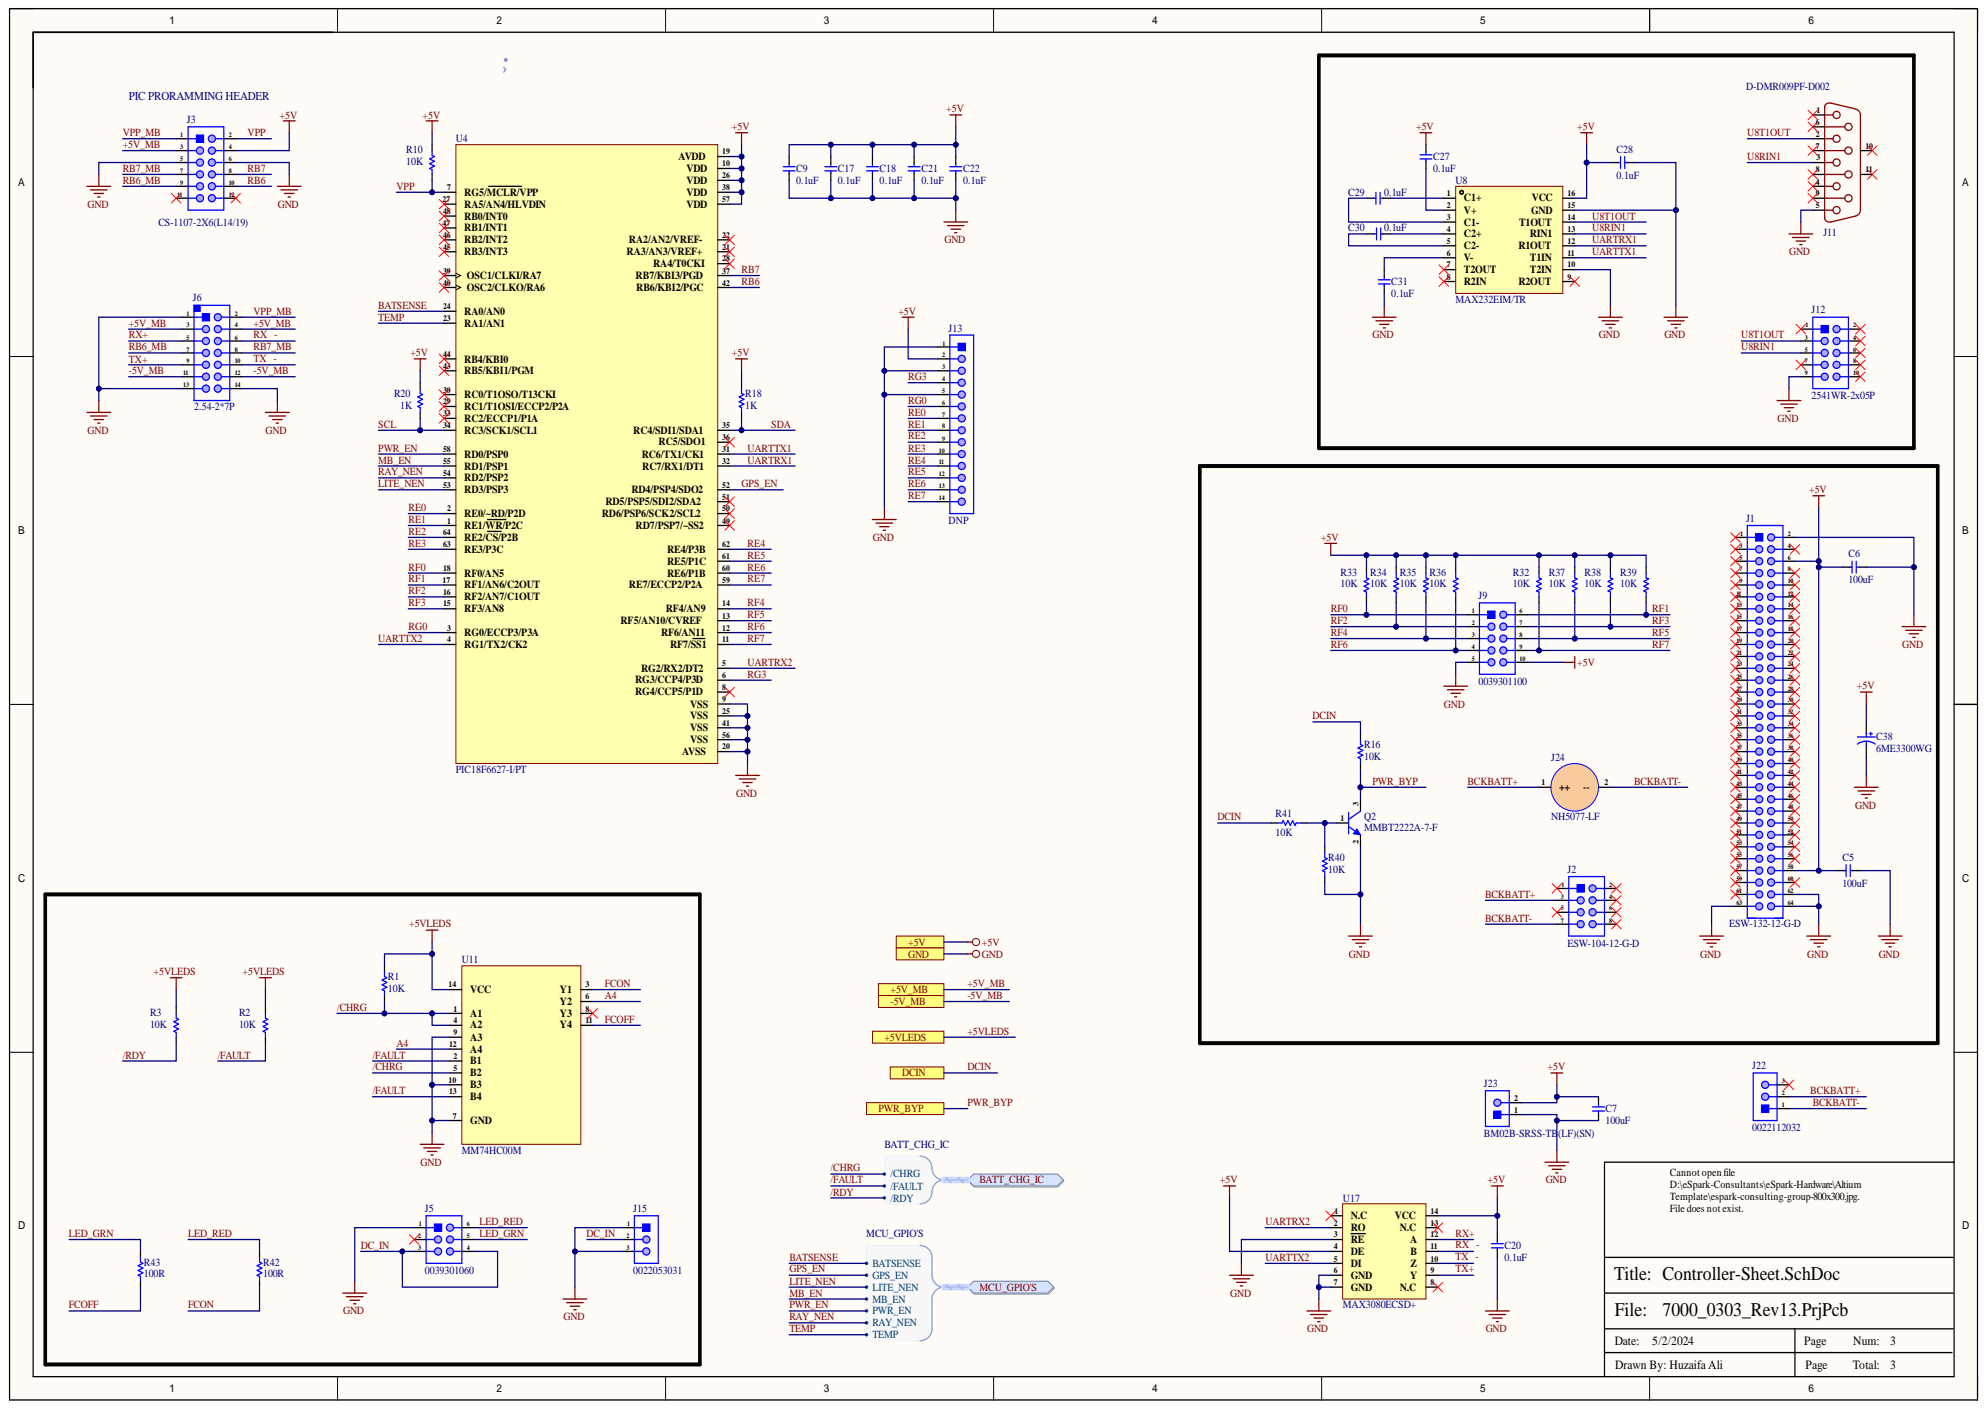
[picture p21: page 3]

Can
D:\eSpark-Consultan
Template\espark-consulting-grou
File does
