eSpark-Backup/eyadkishawi-interfaceboard/(list of files, drawings)

Other design files:
Design-Files/7000_0303_Rev13/7000_0303_Rev13.PrjPcb
Design-Files/7000_0303_Rev13/Controller-Sheet.SchDoc
Design-Files/7000_0303_Rev13/PCB_7000_0303_Rev13.PcbDoc
Design-Files/7000_0303_Rev13/Power-Sheet.SchDoc
Design-Files/7000_0303_Rev13/Top-Sheet.SchDoc
docs/PCB/7000-0303_Rev12.PCB
