eSpark-Backup/eyadkishawi-interfaceboard/(commit log)

2024-04-15 gitignore, docs and schematic pdf added.
2024-04-15 Entry-start point of project created.
    [7000_0303_Rev13.PrjPcb, Controller-Sheet.SchDoc]
2024-04-16 #1 Controller Sheet In Progress
    [Controller-Sheet.SchDoc]
2024-04-17 #1 Power Sheet In Progress
    [Controller-Sheet.SchDoc]
2024-04-18 #1 (Power Circuitry In Progress)
    [Controller-Sheet.SchDoc]
2024-04-22 #1 (Power Sheet Updated)
    [7000_0303_Rev13.PrjPcb, Controller-Sheet.SchDoc, Power-Sheet.SchDoc]
2024-04-23 #1 Schematic Complete.
    [Controller-Sheet.SchDoc, Power-Sheet.SchDoc]
2024-04-24 #1 Added Top Sheet
    [7000_0303_Rev13.PrjPcb, Controller-Sheet.SchDoc, Power-Sheet.SchDoc, Top-Sheet.SchDoc]
2024-04-25 #1 (Labelling of Sections on the Power Sheet)
    [Controller-Sheet.SchDoc, Power-Sheet.SchDoc]
2024-04-26 PCB requirements pushed
2024-04-26 #3 Parts Placement In-progress.
    [7000_0303_Rev13.PrjPcb, Controller-Sheet.SchDoc, PCB_7000_0303_Rev13.PcbDoc, Power-Sheet.SchDoc, Top-Sheet.SchDoc]
2024-04-29 #3 Placement Done: Renderings added.
    [7000_0303_Rev13.PrjPcb, Controller-Sheet.SchDoc, PCB_7000_0303_Rev13.PcbDoc, Power-Sheet.SchDoc, Top-Sheet.SchDoc]
2024-04-30 #3 Routing In-progress.
    [Controller-Sheet.SchDoc, PCB_7000_0303_Rev13.PcbDoc, Power-Sheet.SchDoc, Top-Sheet.SchDoc]
2024-04-30 #3 Routing In-progress
    [Controller-Sheet.SchDoc, PCB_7000_0303_Rev13.PcbDoc, Power-Sheet.SchDoc, Top-Sheet.SchDoc]
2024-05-02 CAD files pushed
2024-05-02 #1 Notes in Schematic & Decoupling Cap at U10 added
    [Controller-Sheet.SchDoc, Power-Sheet.SchDoc]
2024-05-02 #3 Routing in Progress, soldermask & silkscreen color changed as written in doc Capacitor designator updated at pin2 of MAX1771ESA+
    [7000_0303_Rev13.PrjPcb, PCB_7000_0303_Rev13.PcbDoc, Power-Sheet.SchDoc]
2024-05-02 Client's PCb added in Docs folder
    [7000-0303_Rev12.PCB]
2024-05-02 #3 BOM and Other Deliverables generated.
    [7000-0303_Rev12.PCB, 7000_0303_Rev13.PrjPcb, BOM-7000_0303_Rev13.xlsx, Centroid_File-PCB_7000_0303_Rev13.csv, Controller-Sheet.SchDoc, PCB_7000_0303_Rev13.DWG, PCB_7000_0303_Rev13.DXF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]
